Diarmuid1812/MicromouseHAL/README.md

# MicromouseHAL

1. Link do dokumentu Overleaf - Roboty Mobilne etap 2 (bez edycji)
   https://www.overleaf.com/read/mfgwrnbxdtrh
   
2. Link do dokumentu Overleaf - Sterowniki Robotów etap 2 (bez edycji)
   https://www.overleaf.com/read/fxndmzvgxdkn
