Diarmuid1812/MicromouseHAL/KiCadMicromouse/Micromouse.kicad_pcb

## KiCad design KiCadMicromouse/Micromouse.kicad_pcb (2020-05-07)

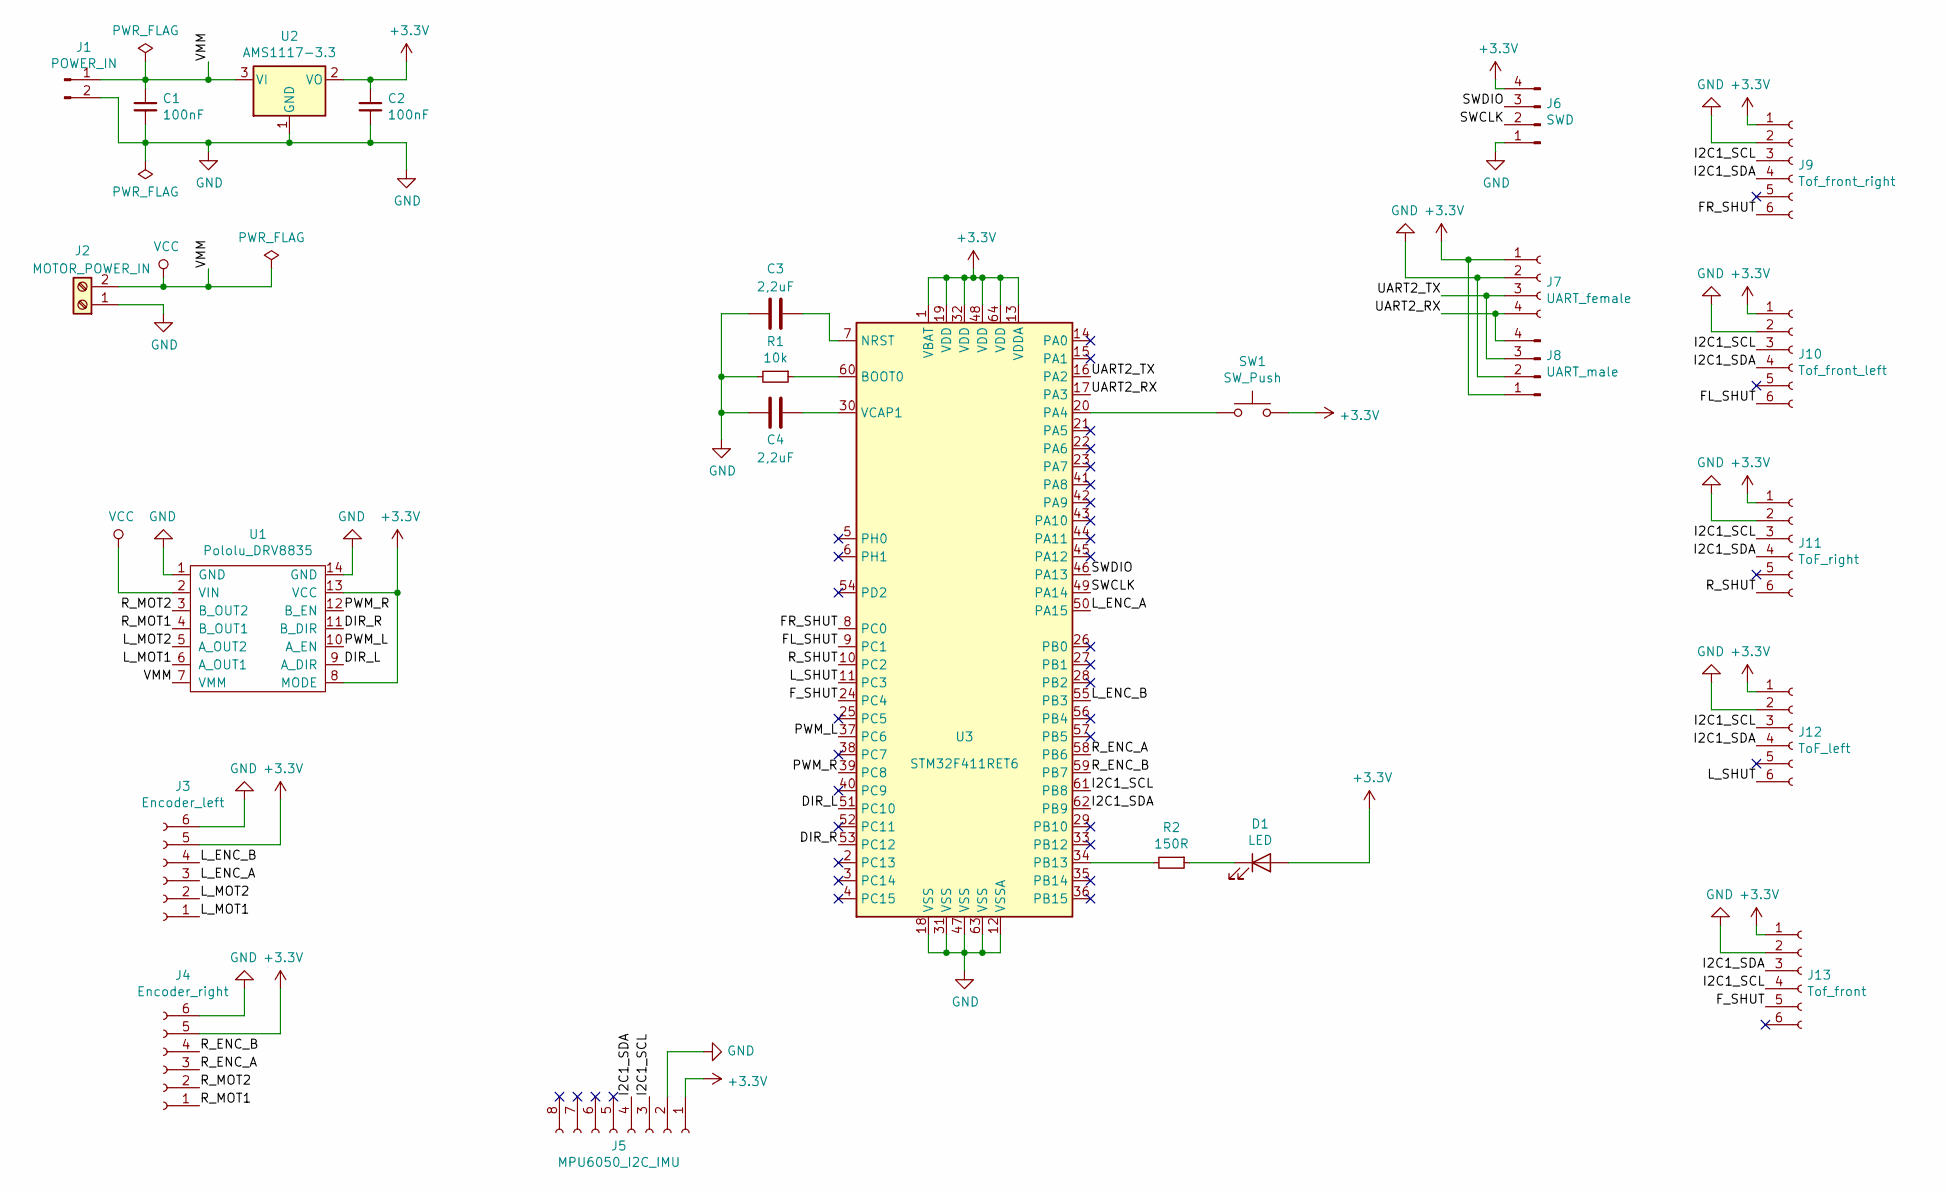
[picture p1: schematic Micromouse.sch]

Parts:
C1, C2: 100nF; C_1206_3216Metric
C3, C4: 2,2uF; C_1206_3216Metric
D1: LED; LED_D3.0mm
J1: POWER_IN; PinHeader_1x02_P2.54mm_Vertical
J2: MOTOR_POWER_IN; TerminalBlock_bornier-2_P5.08mm
J3: Encoder_left; PinSocket_1x06_P2.54mm_Vertical
J4: Encoder_right; PinSocket_1x06_P2.54mm_Vertical
J5: MPU6050_I2C_IMU; PinSocket_1x08_P2.54mm_Vertical
J6: SWD; PinHeader_1x04_P2.54mm_Vertical
J7: UART_female; PinSocket_1x04_P2.54mm_Vertical
J8: UART_male; PinHeader_1x04_P2.54mm_Vertical
J9: Tof_front_right; PinSocket_1x06_P2.54mm_Vertical
J10: Tof_front_left; PinSocket_1x06_P2.54mm_Vertical
J11: ToF_right; PinSocket_1x06_P2.54mm_Vertical
J12: ToF_left; PinSocket_1x06_P2.54mm_Vertical
J13: Tof_front; PinSocket_1x06_P2.54mm_Vertical
R1: 10k; R_1206_3216Metric
R2: 150R; R_1206_3216Metric
SW1: SW_Push; SW_SPST_TL3342
U1: Pololu_DRV8835; Pololu_DRV8835_rev
U2: AMS1117-3.3; SOT-223-3_TabPin2
U3: STM32F411RET6; LQFP-64_10x10mm_P0.5mm

Connections:
+3V3: C2.1, D1.2 (A), J3.5, J4.5, J5.1, J6.4, J7.1, J8.1, J9.1, J10.1, J11.1, J12.1, J13.1, SW1.2, U1.8 (MODE), U1.13 (VCC), U2.2 (VO), U3.1 (VBAT), U3.13 (VDDA), U3.19 (VDD), U3.32 (VDD), U3.48 (VDD), U3.64 (VDD)
/DIR_L: U1.9 (A_DIR), U3.51 (PC10)
/DIR_R: U1.11 (B_DIR), U3.53 (PC12)
/FL_SHUT: J10.6, U3.9 (PC1)
/FR_SHUT: J9.6, U3.8 (PC0)
/F_SHUT: J13.5, U3.24 (PC4)
/I2C1_SCL: J5.3, J9.3, J10.3, J11.3, J12.3, J13.4, U3.61 (PB8)
/I2C1_SDA: J5.4, J9.4, J10.4, J11.4, J12.4, J13.3, U3.62 (PB9)
/L_ENC_A: J3.3, U3.50 (PA15)
/L_ENC_B: J3.4, U3.55 (PB3)
/L_MOT1: J3.1, U1.6 (A_OUT1)
/L_MOT2: J3.2, U1.5 (A_OUT2)
/L_SHUT: J12.6, U3.11 (PC3)
/PWM_L: U1.10 (A_EN), U3.37 (PC6)
/PWM_R: U1.12 (B_EN), U3.39 (PC8)
/R_ENC_A: J4.3, U3.58 (PB6)
/R_ENC_B: J4.4, U3.59 (PB7)
/R_MOT1: J4.1, U1.4 (B_OUT1)
/R_MOT2: J4.2, U1.3 (B_OUT2)
/R_SHUT: J11.6, U3.10 (PC2)
/SWCLK: J6.2, U3.49 (PA14)
/SWDIO: J6.3, U3.46 (PA13)
/UART2_RX: J7.4, J8.4, U3.17 (PA3)
/UART2_TX: J7.3, J8.3, U3.16 (PA2)
GND: C1.2, C2.2, C3.2, C4.2, J1.2, J2.1, J3.6, J4.6, J5.2, J6.1, J7.2, J8.2, J9.2, J10.2, J11.2, J12.2, J13.2, R1.2, U1.1 (GND), U1.14 (GND), U2.1 (GND), U3.12 (VSSA), U3.18 (VSS), U3.31 (VSS), U3.47 (VSS), U3.63 (VSS)
unnamed: C3.1, U3.7 (NRST)
unnamed: C4.1, U3.30 (VCAP1)
unnamed: D1.1 (K), R2.1
unnamed: R1.1, U3.60 (BOOT0)
unnamed: R2.2, U3.34 (PB13)
unnamed: SW1.1, U3.20 (PA4)
VCC: C1.1, J1.1, J2.2, U1.2 (VIN), U1.7 (VMM), U2.3 (VI)

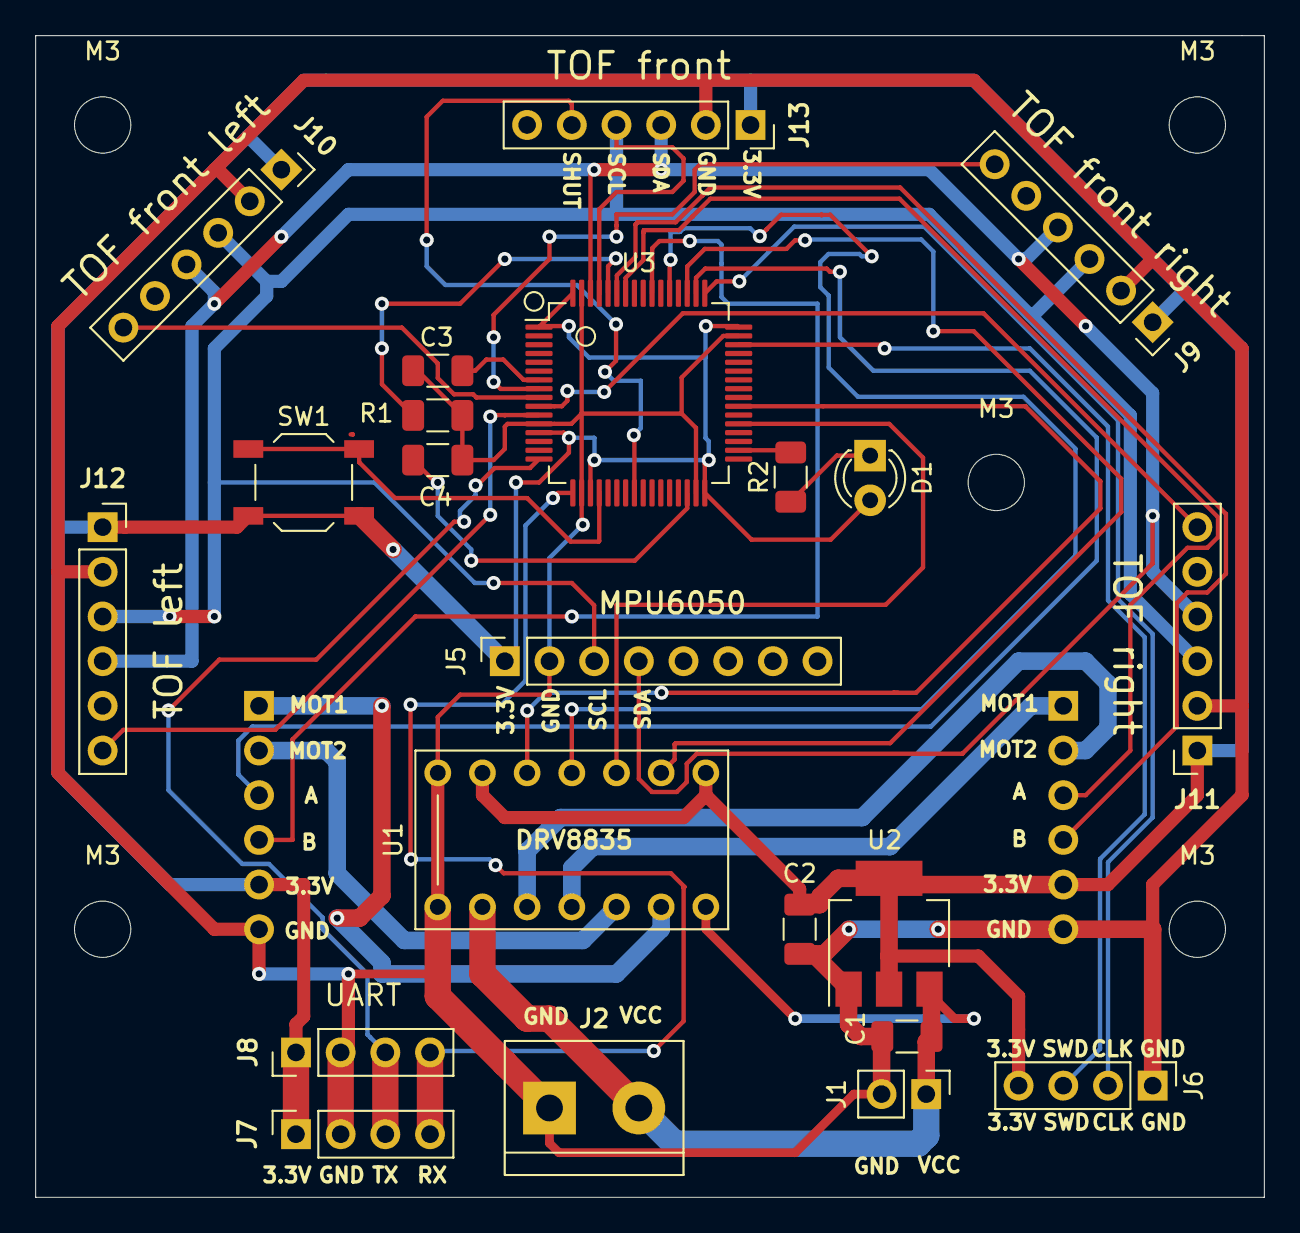
[picture p2: board Micromouse.kicad_pcb from above]

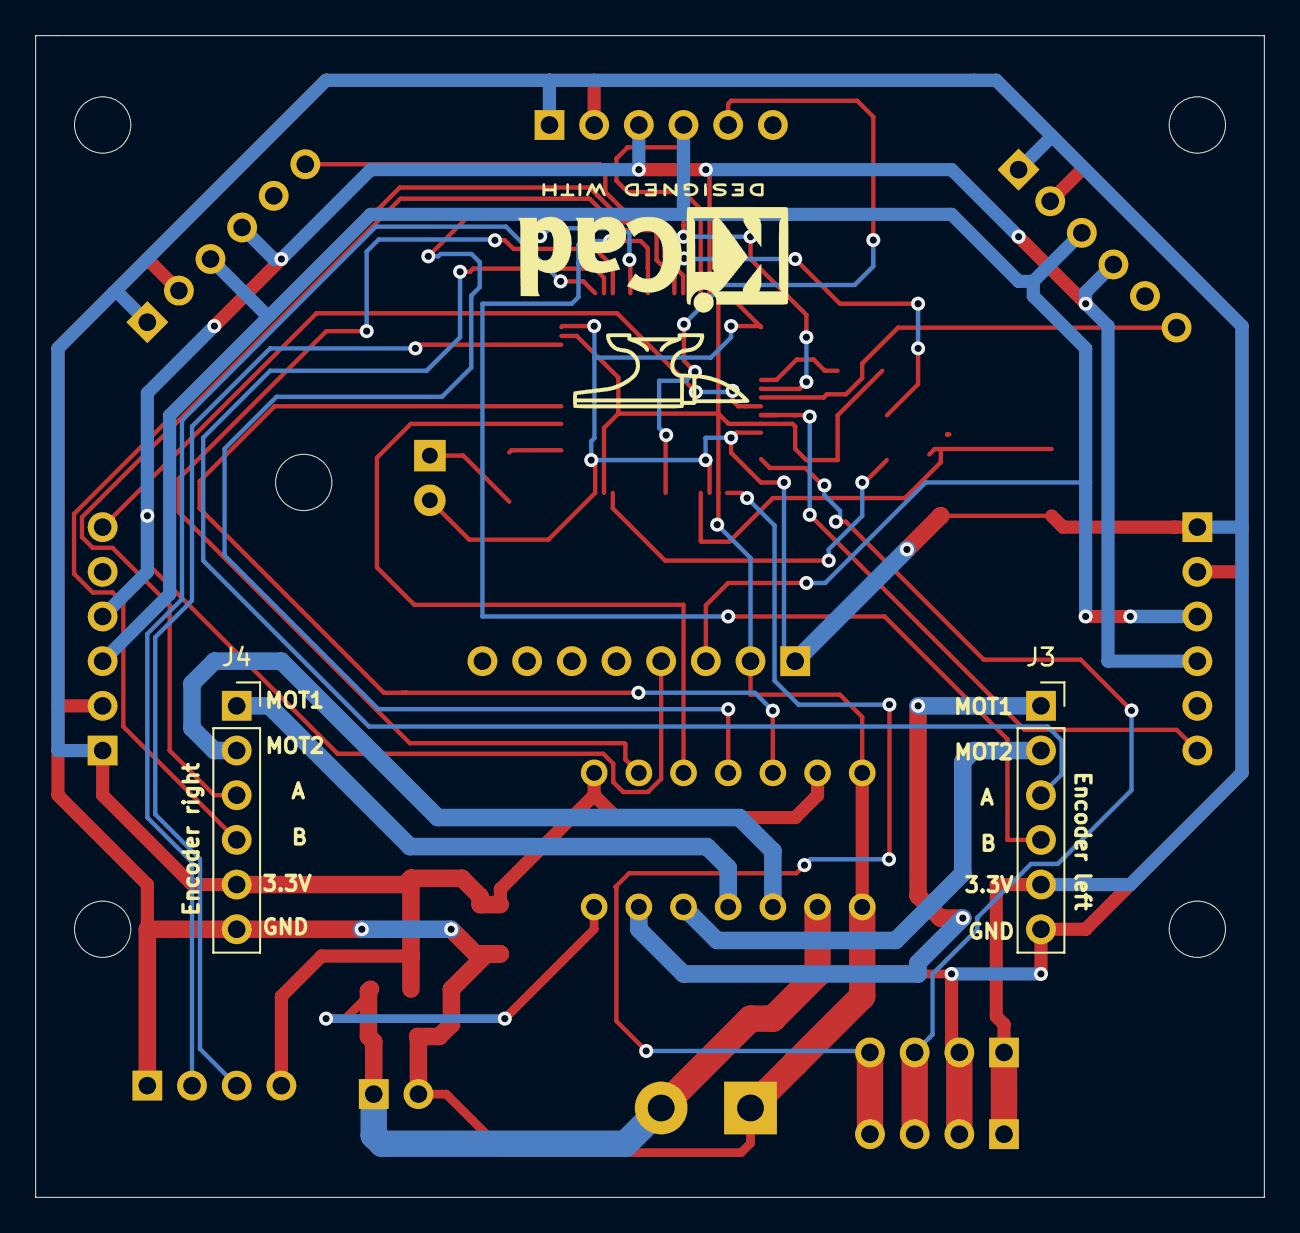
[picture p3: board Micromouse.kicad_pcb from below]

Board: 2 copper layers, 69.9 x 66.0 mm, 29 parts (2 on the bottom side), 32 nets.

Other parts of the board:
M3, M3#2, M3#3, M3#4, M3#5: MountingHole_3.2mm_M3
