Diarmuid1812/MicromouseHAL/HAL_micromouse/Core/Src/main.c

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

/* Includes ------------------------------------------------------------------*/
#include "main.h"
#include "i2c.h"
#include "tim.h"
#include "usart.h"
#include "gpio.h"

/* USER CODE BEGIN Includes */

#include "stdio.h"
#include "VL53L0x.h"
#include "../../MPU6050/mpu6050.h"
#include "move.h"
#include "encoders.h"
#include "SoftwareCRC.h"
#include "mapping.h"
#include "FloodFill.h"

/* USER CODE END Includes */

/* USER CODE BEGIN PD */
//wyższa matematyka
#define PI 3.14159265359

#define CELL_DIST 168


//interwały zdarzań w pętli main w ms
#define DIST_READ_INTERVAL 100
#define BLINK_INTERVAL 500

//makra do obsługi diody LED
#define LED_ON()   HAL_GPIO_WritePin(GPIOB, RED_LED_Pin, 0)
#define LED_OFF()  HAL_GPIO_WritePin(GPIOB, RED_LED_Pin, 1)
#define LED_TOGGLE() HAL_GPIO_TogglePin(GPIOB, RED_LED_Pin)

//makro do obsługi przycisku
#define BUTTON_STATE() HAL_GPIO_ReadPin(BUTTON_GPIO_Port, BUTTON_Pin)

/* USER CODE END PD */


/* USER CODE BEGIN PV */

//zmienne dla regulatora PID
volatile float eps = 0.0f;
volatile uint8_t pidChangedFlag = 0;

//rotacja robota
float rotx = 0;

//zmienne dla MPU6050
float ax = 0, ay = 0, az = 0, gx = 0, gy = 0, gz = 0, temperature = 0;


/* USER CODE END PV */

void SystemClock_Config(void);
/* USER CODE BEGIN 0 */

//przekierowanie printf dla portu szeregowego
int _write(int file, char *ptr, int len)
{
	HAL_UART_Transmit(&huart2, (uint8_t*) ptr, len, 50);
	return len;
}

//timer dla regulatora PID
void HAL_TIM_PeriodElapsedCallback(TIM_HandleTypeDef *htim)
{
	if (htim->Instance == TIM10)
	{
		eps = leftTotal - rightTotal;
		pidChangedFlag = 1;
	}
}

/* USER CODE END 0 */

/**
 * @brief  The application entry point.
 * @retval int
 */
int main(void)
{
	/* MCU Configuration--------------------------------------------------------*/

	/* Reset of all peripherals, Initializes the Flash interface and the Systick. */
	HAL_Init();

	/* Configure the system clock */
	SystemClock_Config();

	/* Initialize all configured peripherals */
	MX_GPIO_Init();
	MX_USART2_UART_Init();
	MX_I2C1_Init();
	MX_TIM2_Init();
	MX_TIM3_Init();
	MX_TIM4_Init();
	MX_TIM10_Init();
	/* USER CODE BEGIN 2 */

	//uruchomienie timera dla PID
	HAL_TIM_Base_Start_IT(&htim10);

	//zmienne lokalne funkcji main - ustawione jako lokalne by były od razu widoczne w debuggerze
	/************************************************************************/

	DirType dir = N;
	DirType nextDir;
	uint8_t posx = 0;
	uint8_t posy = 0;

	//zmienne do podglądu enkoderów
	uint32_t prawy = 0;
	uint32_t lewy = 0;

	//ramka danych na WDS
	char frameWDS[50] =	{0};

	//zmienne do testów VL53L0x
	volatile int dist_F_tmp;
	volatile int dist_L_tmp;
	volatile int dist_R_tmp;
	volatile int dist_FL_tmp;
	volatile int dist_FR_tmp;

	//zmienne do odmierzania interwałów czasowych za pomocą systick
	uint32_t time_ToF = 0;
	uint32_t time_blink = 0;
	uint32_t time_gyro = 0;

	/************************************************************************/

	//zapal LED
	LED_OFF();

	//inicjalizacja czujników ToF
	initMicromouseVL53L0x();

	//inicjalizacja MPU6050

	MPU6050_Init(&hi2c1);
	MPU6050_SetInterruptMode(MPU6050_INTMODE_ACTIVEHIGH);
	MPU6050_SetInterruptDrive(MPU6050_INTDRV_PUSHPULL);
	MPU6050_SetInterruptLatch(MPU6050_INTLATCH_WAITCLEAR);
	MPU6050_SetInterruptLatchClear(MPU6050_INTCLEAR_STATUSREAD);
	MPU6050_SetIntEnableRegister(0);
	MPU6050_SetDlpf(MPU6050_DHPF_5);
	MPU6050_SetFullScaleGyroRange(MPU6050_GYRO_FS_1000);

	//inicjalizacja PWM dla silników
	motorsInit();

	//inicjalizacja enkoderów
	HAL_TIM_Encoder_Start(&htim2, TIM_CHANNEL_ALL);
	HAL_TIM_Encoder_Start(&htim4, TIM_CHANNEL_ALL);

	//inicjalizacja PID do jazdy na wprost
	pidInit(&pidSt,PID_ST_PARAM_KP, PID_ST_PARAM_KI, PID_ST_PARAM_KD, PID_DT, PID_ST_WINDUP);
	//inicjalizacja PID do skrętów
	pidInit(&pidAngle,PID_ANGLE_PARAM_KP, PID_ANGLE_PARAM_KI, PID_ANGLE_PARAM_KD, PID_DT, PID_ANGLE_WINDUP);

	HAL_Delay(1000);

	/* USER CODE END 2 */

	/* Infinite loop */
	/* USER CODE BEGIN WHILE */

	while (1)
	{
		uint32_t czas1 = HAL_GetTick();
		//odczyt danych z mpu6050
		//MPU6050_GetAccelerometerScaled(&ax, &ay, &az);
		MPU6050_GetGyroscopeScaled(&gx, &gy, &gz);
		//temperature = MPU6050_GetTemperatureCelsius();

		//odczyt z enkoderów
		encRead();
		prawy = leftTotal;
		lewy = rightTotal;

		////////////////////////////////////////////////////
		//tutaj test jazdy i obrotu
		static int x = 1;

		if (x == 0)
		{
			printf("posx = %d, posy = %d\n", posx, posy);

			nextDir = floodFill(posx, posy, dir);
			printf("dir = %d, nextDir = %d\n", dir, nextDir);
			if(dir == nextDir)
			{
				while(move_forward(CELL_DIST, 200) == 0);
				if(nextDir == N)
					posy++;
				if(nextDir == S)
					posy--;
				if(nextDir == E)
					posx++;
				if(nextDir == W)
					posx--;
			}
			else if((dir == N && nextDir == E) || (dir == E && nextDir == S) || (dir == S && nextDir == W ) || (dir == W && nextDir == N))
			{
				gx = 0;
				rotx = 0;
				//while(turn_pid(rotx, -90000) == 0)
				while(turn_right(rotx, -90000, 120) == 0)
				{
					MPU6050_GetGyroscopeScaled(&gx, &gy, &gz);
					if(gx > 2 || gx < -2)
					{
						rotx += gx*(HAL_GetTick() - time_gyro);
					}
					time_gyro = HAL_GetTick();
					HAL_Delay(10);

				}
				while(move_forward(CELL_DIST, 200) == 0);
				dir = nextDir;

				if(nextDir == N)
					posy++;
				if(nextDir == S)
					posy--;
				if(nextDir == E)
					posx++;
				if(nextDir == W)
					posx--;
			}
			else if((dir == N && nextDir == W) || (dir == W && nextDir == S) || (dir == S && nextDir == E ) || (dir == E && nextDir == N))
			{
				gx = 0;
				rotx = 0;
				//while(turn_pid(rotx, 90000) == 0)
				while(turn_left(rotx, 90000, 120) == 0)
				{
					MPU6050_GetGyroscopeScaled(&gx, &gy, &gz);
					if(gx > 2 || gx < -2)
					{
						rotx += gx*(HAL_GetTick() - time_gyro);
					}
					time_gyro = HAL_GetTick();
					HAL_Delay(10);

				}
				while(move_forward(CELL_DIST, 200) == 0);
				dir = nextDir;

				if(nextDir == N)
					posy++;
				if(nextDir == S)
					posy--;
				if(nextDir == E)
					posx++;
				if(nextDir == W)
					posx--;
			}
			else if((dir == N && nextDir == S) || (dir == E && nextDir == W) || (dir == S && nextDir == N ) || (dir == W && nextDir == E))
			{
				gx = 0;
				rotx = 0;
				//while(turn_pid(rotx, -180000) == 0)
				while(turn_right(rotx, -180000, 120) == 0)
				{
					MPU6050_GetGyroscopeScaled(&gx, &gy, &gz);
					if(gx > 2 || gx < -2)
					{
						rotx += gx*(HAL_GetTick() - time_gyro);
					}
					time_gyro = HAL_GetTick();
					HAL_Delay(10);

				}
				while(move_forward(CELL_DIST, 200) == 0);
				dir = nextDir;

				if(nextDir == N)
					posy++;
				if(nextDir == S)
					posy--;
				if(nextDir == E)
					posx++;
				if(nextDir == W)
					posx--;
			}
			else
			{
				LED_ON();
				printf("dir = %d, nextDir = %d\n", dir, nextDir);
			}
			if(posx == LABIRYNTH_SIZE-1 && posy == LABIRYNTH_SIZE-1)
			{
				x = 1;

			}
		}


		if(BUTTON_STATE() == 1)
		{
			HAL_Delay(500);
			x = 0;
		}



		// koniec testu jazdy
		////////////////////////////////////////////////////

		//testowy odczyt z czujników ToF
		if ((HAL_GetTick() - time_ToF) >= DIST_READ_INTERVAL)
		{
			dist_F_tmp = ToF_readRangeContinuousMillimeters(&ToF_F);
			dist_R_tmp = ToF_readRangeContinuousMillimeters(&ToF_R);
			dist_L_tmp = ToF_readRangeContinuousMillimeters(&ToF_L);
			dist_FL_tmp = ToF_readRangeContinuousMillimeters(&ToF_FL);
			dist_FR_tmp = ToF_readRangeContinuousMillimeters(&ToF_FR);
			time_ToF = HAL_GetTick();
		}

		//miganie diodą - nieblokujące
//		if ((HAL_GetTick() - time_blink) >= BLINK_INTERVAL)
//		{
//			LED_TOGGLE();
//			time_blink = HAL_GetTick();
//		}

		//inkrementacja obrotu w zmierzonym oknie czasowym
		if(gx > 2 || gx < -2)
		{
			rotx += gx*(HAL_GetTick() - time_gyro);
		}
		time_gyro = HAL_GetTick();

		//generowanie ramki danych na WDS
		//makeFrame(frameString,left_encoder,right_encoder,ToF_L,ToF_FL,ToF_F,ToF_FR,ToF_R);
		//tak powinna wyglądać przykładowa gotowa ramka -> "X_00012_00034_0023_0234_0433_3444_0003_1886576405"
		makeFrame(frameWDS, lewy, prawy, dist_L_tmp, dist_FL_tmp, dist_F_tmp, dist_FR_tmp, dist_R_tmp);
		//wysłanie ramki
		printf("%s\n", frameWDS);


		//pomiar czasu trwania całej pętli
		uint32_t czas2 = HAL_GetTick() - czas1;

		HAL_Delay(0);

		/* USER CODE END WHILE */

		/* USER CODE BEGIN 3 */
	}
	/* USER CODE END 3 */
}

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
