Diarmuid1812/MicromouseHAL/HAL_micromouse/HAL_micromouse.ioc

Mcu.UserName=STM32F411RETx
PA13.GPIO_Label=TMS
PA13.Signal=SYS_JTMS-SWDIO
PA14.GPIO_Label=TCK
PA14.Signal=SYS_JTCK-SWCLK
PA15.GPIO_Label=ENC_L_A
PA15.Signal=S_TIM2_CH1_ETR
PA2.GPIO_Label=USART_TX
PA2.Signal=USART2_TX
PA3.GPIO_Label=USART_RX
PA3.Signal=USART2_RX
PA4.GPIO_Label=BUTTON
PA4.Signal=GPIO_Input
PB13.GPIO_Label=RED_LED
PB13.Signal=GPIO_Output
PB3.GPIO_Label=ENC_L_B
PB3.Signal=S_TIM2_CH2
PB6.GPIO_Label=ENC_R_A
PB6.Signal=S_TIM4_CH1
PB7.GPIO_Label=ENC_R_B
PB7.Signal=S_TIM4_CH2
PB8.GPIO_Label=I2C1_SCL
PB8.Signal=I2C1_SCL
PB9.GPIO_Label=I2C1_SDA
PB9.Signal=I2C1_SDA
PC0.GPIO_Label=TOF_GPIO_FR
PC0.Signal=GPIO_Output
PC1.GPIO_Label=TOF_GPIO_FL
PC1.Signal=GPIO_Output
PC10.GPIO_Label=DIR_L
PC10.Signal=GPIO_Output
PC12.GPIO_Label=DIR_R
PC12.Signal=GPIO_Output
PC13-ANTI_TAMP.GPIO_Label=B1 [Blue PushButton]
PC13-ANTI_TAMP.Signal=GPXTI13
PC2.GPIO_Label=TOF_GPIO_R
PC2.Signal=GPIO_Output
PC3.GPIO_Label=TOF_GPIO_L
PC3.Signal=GPIO_Output
PC4.GPIO_Label=TOF_GPIO_F
PC4.Signal=GPIO_Output
PC6.GPIO_Label=PWML
PC6.Signal=S_TIM3_CH1
PC8.GPIO_Label=PWMR
PC8.Signal=S_TIM3_CH3
