Diarmuid1812/MicromouseHAL/HAL_micromouse/Core/Inc/pid.h

/*
 * pid.h
 *
 *  Created on: May 11, 2020
 *      Author: Mikolaj Szustakiewicz
 */

#ifndef INC_PID_H_
#define INC_PID_H_
typedef struct
{
	//nastawy regulatora - wzmocnienia członów
	float pidKp;
	float pidKi;
	float pidKd;

	//filtr przeciwnasyceniowy członu całkującego - windup

	float C_windup;

	//uchyb poprzedni
	float ep;

	//całka
	float C;
	//wyjście regulatora
	float U;
	//podstawa czasu
	float dt;
}PIDtype_f;

void pidInit(PIDtype_f * pid, float kp_param, float ki_param, float kd_param, float dt_param, float C_windup_param);

void pidReset(PIDtype_f * pid);
float pidCalc(PIDtype_f * pid, float eps);

#endif /* INC_PID_H_ */
