Diarmuid1812/MicromouseHAL/HAL_micromouse/Core/Inc/FloodFill.h

/*
 * FloodFill.h
 *
 *  Created on: 14 maj 2020
 *      Author: Diarmuid
 */

#ifndef INC_FLOODFILL_H_
#define INC_FLOODFILL_H_

DirType floodFill(uint8_t posX, uint8_t posY, DirType dir);

#endif /* INC_FLOODFILL_H_ */
