Diarmuid1812/MicromouseHAL/(commit log)

2020-05-02 Wersja bazowa do rozwoju
    + generowanie kodu z Cube jako osobnych par plików .c/.h dla każdego peryferium
    + ostateczna konfiguracja peryferiów w Cube
    + działające funkcje kontroli silników
    + działający odczyt danych z MPU6050
    + działający odczyt danych z enkoderów
    + biblioteka HAL dla VL53L0x, działające odczyty i zapisy do rejestrów
    Do zrobienia:
    - porównanie biblioteki HAL i StdPeriph dla VL53L0x przy użyciu analizatora stanów logicznych
    - naprawienie odczytu z VL53L0x, problem prawdopodobnie w inicjalizacji czujnika
    [HAL_micromouse.ioc, VL53L0x.c, VL53L0x.h, encoders.c, encoders.h, main.c]
2020-05-03 Przekierowanie printf() na port szeregowy
    + Przekierowanie funkcji printf() na USART2, 115200 baudrate
2020-05-07 Projekt elektroniki w KiCad
    +dodano projekt elektroniki z programu KiCad w folderze KiCadMicromouse
    +usunięto nieużywany projekt CubeIDE ze wstępną konfiguracją peryferiów
    [Micromouse-B_Cu.gbl, Micromouse-B_Mask.gbs, Micromouse-B_SilkS.gbo, Micromouse-Edge_Cuts.gm1, Micromouse-F_Cu.gtl, Micromouse-F_Mask.gts, Micromouse-F_SilkS.gto, Micromouse-NPTH.drl]
2020-05-11 Dodanie .gitignore, poprawienie błędu w VL53L0x.c
    +dodano plik .gitignore do repozytorium. Ignorowany jest katalog HAL_micromouse/Debug i pliki zapasowe KiCad.
    +poprawiono błąd w funkcji ToF_readMulti()
    +usunięto ścieżki nieużywanych bibliotek
2020-05-23 Regulator PID - jazda do przodu
    + uruchomienie TIM10 dla regulatora PID
    + dodanie makr do obsługi diody LED
    + wstępne nastawy PID
    + poprawienie błędu resetowania enkoderów
    [HAL_micromouse.ioc, encoders.c, main.c, pid.c]
2020-05-24 Ruchy na wprost o zadaną odległość z PID
    + umieszczenie regulatora PID w pliku move.c w funkcjach odpowiedzialnych za ruch do przodu i do tyłu
    + uzupełnienie funkcji ruchu o dystans i prędkość
    + funkcje ruchu działają teraz nieblokująco, po wywołaniu wyzwalają ruch, a potem sprawdzają, czy już się skończył. Zwracają wartość 0 lub 1 zależnie od wartości enkoderów. Po zakończeniu resetują stan enkoderów
    + dodano makro do obsługi przycisku
    + przeorganizowano pliki pid.c i pid.h
    [main.c, move.c, move.h, pid.c, pid.h]
2020-05-25 PID obiektowo
2020-05-26 Rotacja robota oparta o żyroskop
    + pomiar rotacji w oparciu o żyroskop
    + funkcje obrotu w prawo i w lewo o zadany kąt. Działają bardzo precyzyjnie dla kątów większych niż kilkanaście stopni, z prędkością silników 100
    +funkcja obrotu z regulatorem PID. Wymaga poprawy nastaw, wykazuje długo gasnące oscylacje w końcowej fazie stabilizacji
    + zmiana z PID ISA na PID IND -wzmocnienie członu proporcjonalnego nie wpływa na wzmocnienia innych członów
    +instancje struktur PID umieszczone w pliku move.h
2020-05-30 Windup dla członu I regulatora PID
    +dodano windup członu I - zabezpieczenie przez nieograniczonym narastaniem całki
    +dobrano parametry regulatora PID dla obrotu. Funkcja bez PID wciąż działa nieco lepiej, ale z PID jest już ok
